sebastianbeyer/SO_hihat/kicad/hihat_BOM.md

# hihat.kicad_sch BOM

Tue 22 Nov 2022 12:08:40 CET

Generated from schematic by Eeschema 6.0.8-f2edbf62ab~116~ubuntu22.04.1

**Component Count:** 168

| Refs | Qty | Component | Description | Vendor | SKU |
| ----- | --- | ---- | --- | ---- | ---- |
| C1, C12 | 2 | 10n | Unpolarized capacitor | Tayda |  |
| C2, C3, C16 | 3 | 10u | Polarized capacitor | Tayda |  |
| C4 | 1 | 22n | Unpolarized capacitor | Tayda |  |
| C5, C8, C19 | 3 | 18n | Unpolarized capacitor | Tayda |  |
| C6, C7 | 2 | 3.3n | Unpolarized capacitor | Tayda |  |
| C9, C14, C15 | 3 | 10n | Unpolarized capacitor | Tayda |  |
| C10 | 1 | 47u | Polarized capacitor | Tayda |  |
| C11, C13 | 2 | .47u | Polarized capacitor | Tayda |  |
| C17, C18 | 2 | 1n | Unpolarized capacitor | Tayda |  |
| C20, C21, C27, C28, C29, C30, C31, C32 | 8 | 100n | Unpolarized capacitor |  |  |
| C22, C24 | 2 | 100n | Unpolarized capacitor | Tayda |  |
| C23 | 1 | 0.33u | Polarized capacitor | Tayda |  |
| C25 | 1 | 470n | Unpolarized capacitor | Tayda |  |
| C26 | 1 | 1u | Polarized capacitor | Tayda |  |
| D1, D2, D5, D6, D9 | 5 | 1N4148 | Standard switching diode, DO-35 | Tayda | A-157 |
| D3, D4 | 2 | 1N5817 | Schottky Barrier Rectifier Diode, DO-41 | Tayda | A-159 |
| D7 | 1 | LED_red_OH | Light emitting diode | Tayda | A-1554 |
| D8 | 1 | LED_red_CH | Light emitting diode | Tayda | A-1554 |
| H1, H2, H3, H4 | 4 | MountingHole | Mounting Hole with connection |  |  |
| J1 | 1 | Synth_power_2x5 | Pin header 2.54 mm 2x5 | Tayda | A-2939 |
| J2 | 1 | CH trig | Audio Jack, 2 Poles (Mono / TS), Switched T Pole (Normalling) | Tayda | A-1121 |
| J3 | 1 | accent | Audio Jack, 2 Poles (Mono / TS), Switched T Pole (Normalling) | Tayda | A-1121 |
| J4 | 1 | CH out | Audio Jack, 2 Poles (Mono / TS), Switched T Pole (Normalling) | Tayda | A-1121 |
| J5 | 1 | ctrl_north | Generic connector, single row, 01x12, script generated (kicad-library-utils/schlib/autogen/connector/) |  |  |
| J6 | 1 | brain_north | Generic connector, single row, 01x12, script generated (kicad-library-utils/schlib/autogen/connector/) |  |  |
| J7 | 1 | OH trig | Audio Jack, 2 Poles (Mono / TS), Switched T Pole (Normalling) | Tayda | A-1121 |
| J8 | 1 | OH out | Audio Jack, 2 Poles (Mono / TS), Switched T Pole (Normalling) | Tayda | A-1121 |
| J9 | 1 | ctrl_south | Generic connector, single row, 01x12, script generated (kicad-library-utils/schlib/autogen/connector/) |  |  |
| J10 | 1 | brain_south | Generic connector, single row, 01x12, script generated (kicad-library-utils/schlib/autogen/connector/) |  |  |
| J11 | 1 | CVin | Audio Jack, 2 Poles (Mono / TS), Switched T Pole (Normalling) | Tayda | A-1121 |
| Q1, Q4, Q5, Q6 | 4 | BC556 | 0.1A Ic, 65V Vce, PNP Small Signal Transistor, TO-92 |  |  |
| Q2, Q3, Q7, Q8, Q9, Q10, Q11, Q12, Q15, Q16 | 10 | BC546 | 0.1A Ic, 65V Vce, Small Signal NPN Transistor, TO-92 |  |  |
| Q13 | 1 | BC546 | 0.1A Ic, 65V Vce, Small Signal NPN Transistor, TO-92 |  |  |
| Q14 | 1 | 2N3904 | Small Signal NPN Transistor, TO-92 | Tayda | A-111 |
| R1, R35 | 2 | 47k | Resistor | Tayda |  |
| R2, R3, R4, R7, R9, R12, R16, R18, R36, R37, R56, R66, R68, R71, R78, R80, R81 | 17 | 100k | Resistor | Tayda |  |
| R5, R62 | 2 | 300k | Resistor | Tayda |  |
| R6, R74 | 2 | 82k | Resistor | Tayda |  |
| R8 | 1 | 270k | Resistor | Tayda |  |
| R10 | 1 | 220k | Resistor | Tayda |  |
| R11, R22, R24, R25, R40, R42, R43 | 7 | 22k | Resistor | Tayda |  |
| R13 | 1 | 680k | Resistor | Tayda |  |
| R14, R64, R77 | 3 | 20k | Resistor | Tayda |  |
| R15, R20, R27, R28, R39, R41, R46, R48, R59, R60, R61, R73 | 12 | 10k | Resistor | Tayda |  |
| R17, R30, R52, R79 | 4 | 100 | Resistor | Tayda |  |
| R19, R33, R34, R57, R58 | 5 | 470 | Resistor | Tayda |  |
| R21, R38, R67, R70 | 4 | 4.7k | Resistor | Tayda |  |
| R23, R44, R53 | 3 | 33k | Resistor | Tayda |  |
| R26, R31, R32, R50, R54, R55 | 6 | 1k | Resistor | Tayda |  |
| R29, R45, R49 | 3 | 15k | Resistor | Tayda |  |
| R47 | 1 | 1M | Resistor | Tayda |  |
| R63, R69 | 2 | 560k | Resistor | Tayda |  |
| R65 | 1 | 8.2k | Resistor | Tayda |  |
| R72 | 1 | 470k | Resistor | Tayda |  |
| R75, R76 | 2 | 2k | Resistor | Tayda |  |
| R82 | 1 | 75 | Resistor | Tayda |  |
| RV1 | 1 | 10k B OH drive | Potentiometer | Tayda |  |
| RV2 | 1 | 10k B CH drive | Potentiometer | Tayda |  |
| RV3 | 1 | 10k A tone | Potentiometer | Tayda |  |
| RV4 | 1 | 100k B CV att | Potentiometer | Tayda |  |
| RV5 | 1 | 100k B OH decay | Potentiometer | Tayda |  |
| RV6 | 1 | 100k B sizzle | Potentiometer | Tayda |  |
| RV7 | 1 | 50k | Trim-potentiometer | Tayda |  |
| SW1 | 1 | mute | Switch, single pole double throw, center OFF position |  |  |
| U1, U4, U8 | 3 | TL074 | Quad operational amplifier, DIP-14 | Tayda | A-1138 |
| U2 | 1 | LM7805_TO220 | Positive 1A 35V Linear Regulator, Fixed Output 5V, TO-220 |  |  |
| U5 | 1 | LM13700 | Dual OTA, DIP-16 | Tayda | A-900 |
| U6 | 1 | Vactrol | Vactrol |  |  |
| U7 | 1 | 40106 | Hex Schmitt trigger inverter |  |  |
