sebastianbeyer/SO_hihat/spice/808_filter_test_transistor_opamp.asc

C1: cap; 1n
C2: cap; 1n
C9: cap; 1n
C10: cap; 1.5n
C11: cap; 470p
C14: cap; 1n
C20: cap; 22n
C21: cap; 1.5n
C22: cap; 1.5n
C23: cap; 1.5n
D3: diode; 1N4148
Q6: npn; BC546B
Q13: npn; BC546B
Q17: npn; BC546B
R1: res; 18k
R2: res; 18k
R3: res; {Rf}
R4: res; 4.7k
R34: res; 2.7k
R35: res; 68k
R36: res; 22k
R55: res; 33k
R57: res; 2.7k
R58: res; 68k
R59: res; 22k
R65: res; 2Meg
R66: res; 100
U3: opamp2; TL074
V3: voltage; 12
V4: voltage; -12
V5: voltage; {V_acc}
V6: voltage; AC 1
Named nets: 0, VCC, VSS, V_accent, noise, transistor, sallen_key, 808_orig
.ac dec 100 1 20000
.inc TL074.mod
;.step param X list 100 25k 50k 250k 500k
;.step param V_acc list 1 2 5 7 10
.param V_acc=10
sallen key filter highpass
gain: 1+R3/R4
if C1=C2 and R1=R2, f_c = 1/(2pi RC)
;.step param Rf list 7k 8.2k 8.5k 9k 10k
.param Rf=8.2k
