sebastianbeyer/SO_hihat/spice/808_hihat_bandpass_checkfreqresponse.asc

C15: cap; 1n
C19: cap; 3.3n
C20: cap; 3.3n
R73: res; 22k
R75: res; 82k
U19: opamp2; TL074
V1: voltage; AC 1
V3: voltage; 12
V4: voltage; -12
X4: pot_log; R=10k Rot={Rot_filter}
Named nets: 0, VCC, VSS, noise
.inc TL074.mod
.lib lm13700.sub
;.step param Rot_filter list 1 10 20 30 40 50 60 70 80 90 99
.param Rot_filter=20
.ac dec 100 1 20000
;.step param Rot_filter list 99 1
