sebastianbeyer/SO_hihat/spice/808_hihat_check_overdrivewithsinewave.asc

C1: cap; 0.01µ
C2: cap; 0.01µ
C5: cap; 10µ
C7: cap; 0.47µ
C10: cap; 10µ
C11: cap; 10µ
C16: cap; 0.47µ
C17: cap; 47µ
C18: cap; 0.01µ
D1: diode; 1N4148
D2: diode; 1N4148
D4: diode; 1N4148
Q1: npn; BC546B
Q2: pnp; BC556B
Q3: pnp; BC556B
Q5: npn; BC546B
Q13: npn; BC546B
Q14: pnp; BC556B
Q15: npn; BC546B
Q16: npn; BC546B
Q17: npn; BC546B
Q18: npn; BC546B
Q19: npn; BC546B
Q20: pnp; BC556B
R1: res; 47k
R2: res; 22k
R3: res; 10k
R4: res; 1k
R5: res; 10k
R6: res; 100k; tol=1
R11: res; 1k
R12: res; 470
R13: res; 470
R14: res; 100
R15: res; 10k
R16: res; 15k
R17: res; 100k
R18: res; 8k
R19: res; 100k
R20: res; 22k
R22: res; 1k
R24: res; 4.7k
R25: res; 22k
R26: res; 100k; tol=1
R27: res; 100k
R30: res; 10k
R31: res; 100k
R33: res; 1k
R34: res; 10k
R35: res; 10k
R36: res; 1Meg
R37: res; 470
R38: res; 470
R39: res; 33k
R41: res; 33k
R42: res; 100k
R43: res; 100
R44: res; 10k
R45: res; 10k
R46: res; {R_choke}
R47: res; 14k
R48: res; 1k
R49: res; 15k
R50: res; 100k
R51: res; 8k
R52: res; 22k
R53: res; 10k
R54: res; 22k
R56: res; 100
R57: res; 100k
R60: res; 4.7k
R61: res; 470
R62: res; 22k
R63: res; 33k
R64: res; 100k; tol=1
R67: res; 1k
R68: res; 10k
U1: opamp2; TL074
U2: LM13700
U3: opamp2; TL074
U4: opamp2; TL074
U5: opamp2; TL074
U7: LM13700
U8: opamp2; TL074
U9: opamp2; TL074
U10: opamp2; TL074
U13: opamp2; TL074
U16: opamp2; TL074
V1: voltage; PULSE(0 5 0.3 0.0001 0.0001 0.1)
V2: voltage; PULSE(0 5 0.1 0.0001 0.0001 0.1)
V3: voltage; 12
V4: voltage; -12
V5: voltage; {V_acc}
V6: voltage; SINE(0 3 10000)
V7: voltage; PULSE(0 5 0.02 0.0001 0.0001 0.1)
X1: pot_lin; R=100k Rot={Rot_decay}
X2: pot_lin; R=10k Rot={Rot_drive}
X3: pot_lin; R=10k Rot={Rot_drive}
Named nets: 0, VCC, VSS, V_accent, accent, CH_trig, CH_env, 12V_isolation, OH_trig, OH_env, filtered_noise, wavout_ota_ch, ch_ota_out, noise, wavout_ota_oh, oh_ota_out
.tran 1 uic
.inc TL074.mod
;.step param X list 100 25k 50k 250k 500k
.lib lm13700.sub
Envelope generator
;.step param V_acc list 1 2 5 7 10
.param V_acc=10
;.step param R_choke list 10k 300k 100000meg
.param R_choke=10000000meg
;.step param Rot_decay list 0.1 10 20 30 40 50 60 70 80 90 99
.lib lm13700.sub
.wave {Rot_sizzle} 16 44.1K V(wavout_ota_ch) V(wavout_ota_oh)
.param Rot_decay 50
;.param Rot_drive=60
.step param Rot_drive list 0.1 10 20 30 40 50 60 70 80 90 99
;.wave hihat_ota_open.wav 16 44.1K V(wavout_ota_oh)
;.wave hihat_ota_combined.wav 16 44.1K V(wavout_ota_ch)
