sebastianbeyer/SO_hihat/spice/808_hihat_completo.asc

B1: bi; V=WHITE(2e6*time)*5
C1: cap; 0.01µ
C2: cap; 0.01µ
C3: cap; 1n
C4: cap; 1n
C5: cap; 10µ
C6: cap; 10n
C7: cap; 0.47µ
C8: cap; 22.44n
C9: cap; 18n
C10: cap; 10µ
C11: cap; 10µ
C12: cap; 18n
C13: cap; 10n
C14: cap; 9.256n
C15: cap; 1n
C16: cap; 0.47µ
C17: cap; 47µ
C18: cap; 0.01µ
C19: cap; 3.3n
C20: cap; 3.3n
D1: diode; 1N4148
D2: diode; 1N4148
D4: diode; 1N4148
Q1: npn; BC546B
Q2: pnp; BC556B
Q3: pnp; BC556B
Q5: npn; BC546B
Q13: npn; BC546B
Q14: pnp; BC556B
Q15: npn; BC546B
Q16: npn; BC546B
Q17: npn; BC546B
Q18: npn; BC546B
Q19: npn; BC546B
Q20: pnp; BC556B
R1: res; 47k
R2: res; 22k
R3: res; 10k
R4: res; 1k
R5: res; 10k
R6: res; 100k; tol=1
R7: res; 18k
R8: res; 18k
R9: res; 8.2k
R10: res; 4.7k
R11: res; 1k
R12: res; 470
R13: res; 470
R14: res; 100
R15: res; 10k
R16: res; 15k
R17: res; 100k
R18: res; 8k
R19: res; 100k
R20: res; 22k
R21: res; 100k
R22: res; 1k
R23: res; 560k
R24: res; 4.7k
R25: res; 22k
R26: res; 100k; tol=1
R27: res; 100k
R28: res; 100k
R29: res; 299k
R30: res; 10k
R31: res; 100k
R32: res; 100k
R33: res; 1k
R34: res; 10k
R35: res; 10k
R36: res; 1Meg
R37: res; 470
R38: res; 470
R39: res; 33k
R41: res; 33k
R42: res; 100k
R43: res; 100
R44: res; 10k
R45: res; 10k
R46: res; {R_choke}
R47: res; 14k
R48: res; 1k
R49: res; 15k
R50: res; 100k
R51: res; 8k
R52: res; 22k
R53: res; 10k
R54: res; 22k
R55: res; 270k
R56: res; 100
R57: res; 100k
R58: res; 100k
R59: res; 220k
R60: res; 4.7k
R61: res; 470
R62: res; 22k
R63: res; 33k
R64: res; 100k; tol=1
R65: res; 100k
R66: res; 680k
R67: res; 1k
R68: res; 10k
R69: res; 100k
R70: res; 556.6k
R71: res; 100k
R72: res; 100k
R73: res; 22k
R74: res; 10k
R75: res; 82k
R76: res; 50k
U1: opamp2; TL074
U2: LM13700
U3: opamp2; TL074
U4: opamp2; TL074
U5: opamp2; TL074
U6: opamp2; TL074
U7: LM13700
U8: opamp2; TL074
U9: opamp2; TL074
U10: opamp2; TL074
U11: CD40106B
U12: CD40106B
U13: opamp2; TL074
U14: CD40106B
U15: CD40106B
U16: opamp2; TL074
U17: CD40106B
U18: CD40106B
U19: opamp2; TL074
U20: opamp2; TL074
V1: voltage; PULSE(0 5 0.3 0.0001 0.0001 0.1)
V2: voltage; PULSE(0 5 0.1 0.0001 0.0001 0.1)
V3: voltage; 12
V4: voltage; -12
V5: voltage; {V_acc}
V6: voltage; SINE(0 0.2 10000)
V7: voltage; PULSE(0 5 0.02 0.0001 0.0001 0.1)
X1: pot_lin; R=100k Rot={Rot_decay}
X2: pot_lin; R=10k Rot={Rot_drive}
X3: pot_lin; R=10k Rot={Rot_drive}
X4: pot_log; R=10k Rot={Rot_filter}
X5: pot_lin; R=10k Rot={Rot_drive}
Named nets: 0, VCC, VSS, V_accent, accent, CH_trig, CH_env, 12V_isolation, OH_trig, OH_env, filtered_noise, wavout_ota_ch, ch_ota_out, noise, wavout_ota_oh, oh_ota_out
.tran .05 uic
.inc TL074.mod
;.step param X list 100 25k 50k 250k 500k
.lib lm13700.sub
Envelope generator
.inc CD4000.lib
;.step param V_acc list 1 2 5 7 10
.param V_acc=10
;.step param R_choke list 10k 300k 100000meg
.param R_choke=10000000meg
;.step param Rot_decay list 0.1 10 20 30 40 50 60 70 80 90 99
.lib lm13700.sub
.wave {Rot_drive} 16 44.1K V(wavout_ota_ch) V(wavout_ota_oh)
.param Rot_decay 50
sallen key filter highpass
gain: 1+R3/R4
if C1=C2 and R1=R2, f_c = 1/(2pi RC)
;.param Rot_drive=60
.step param Rot_drive list 0.1 10 20 30 40 50 60 70 80 90 99
;.wave hihat_ota_open.wav 16 44.1K V(wavout_ota_oh)
;.step param Rot_filter list 1 10 20 30 40 50 60 70 80 90 99
.param Rot_filter=25
;.wave hihat_ota_combined.wav 16 44.1K V(wavout_ota_ch)
V=WHITE(2e6*time)*10
.param Rot_sizzle=10
;.step param Rot_sizzle list 1 5 10 20 30 40 50 60 70 90 99
