sebastianbeyer/SO_hihat/spice/pot_lin.asc

R1: res; {Ra}
R2: res; {Rb}
Named nets: 1, 2, 3
.param Ra=R*(Rot/100)
.param Rb=R*(1-(Rot/100))
