sebastianbeyer/SO_hihat/spice/pot_log.asc

R1: res; {Ra}
R2: res; {Rb}
Named nets: 1, 2, 3
.param Ra={if(Rot<=50,R*(Rot/100/5),R*(Rot/100*2.2-1.2))}
.param Rb={R-Ra}
