sebastianbeyer/SO_hihat/kicad/hihat.kicad_pcb

## KiCad design kicad/hihat.kicad_pcb (2022-02-02)

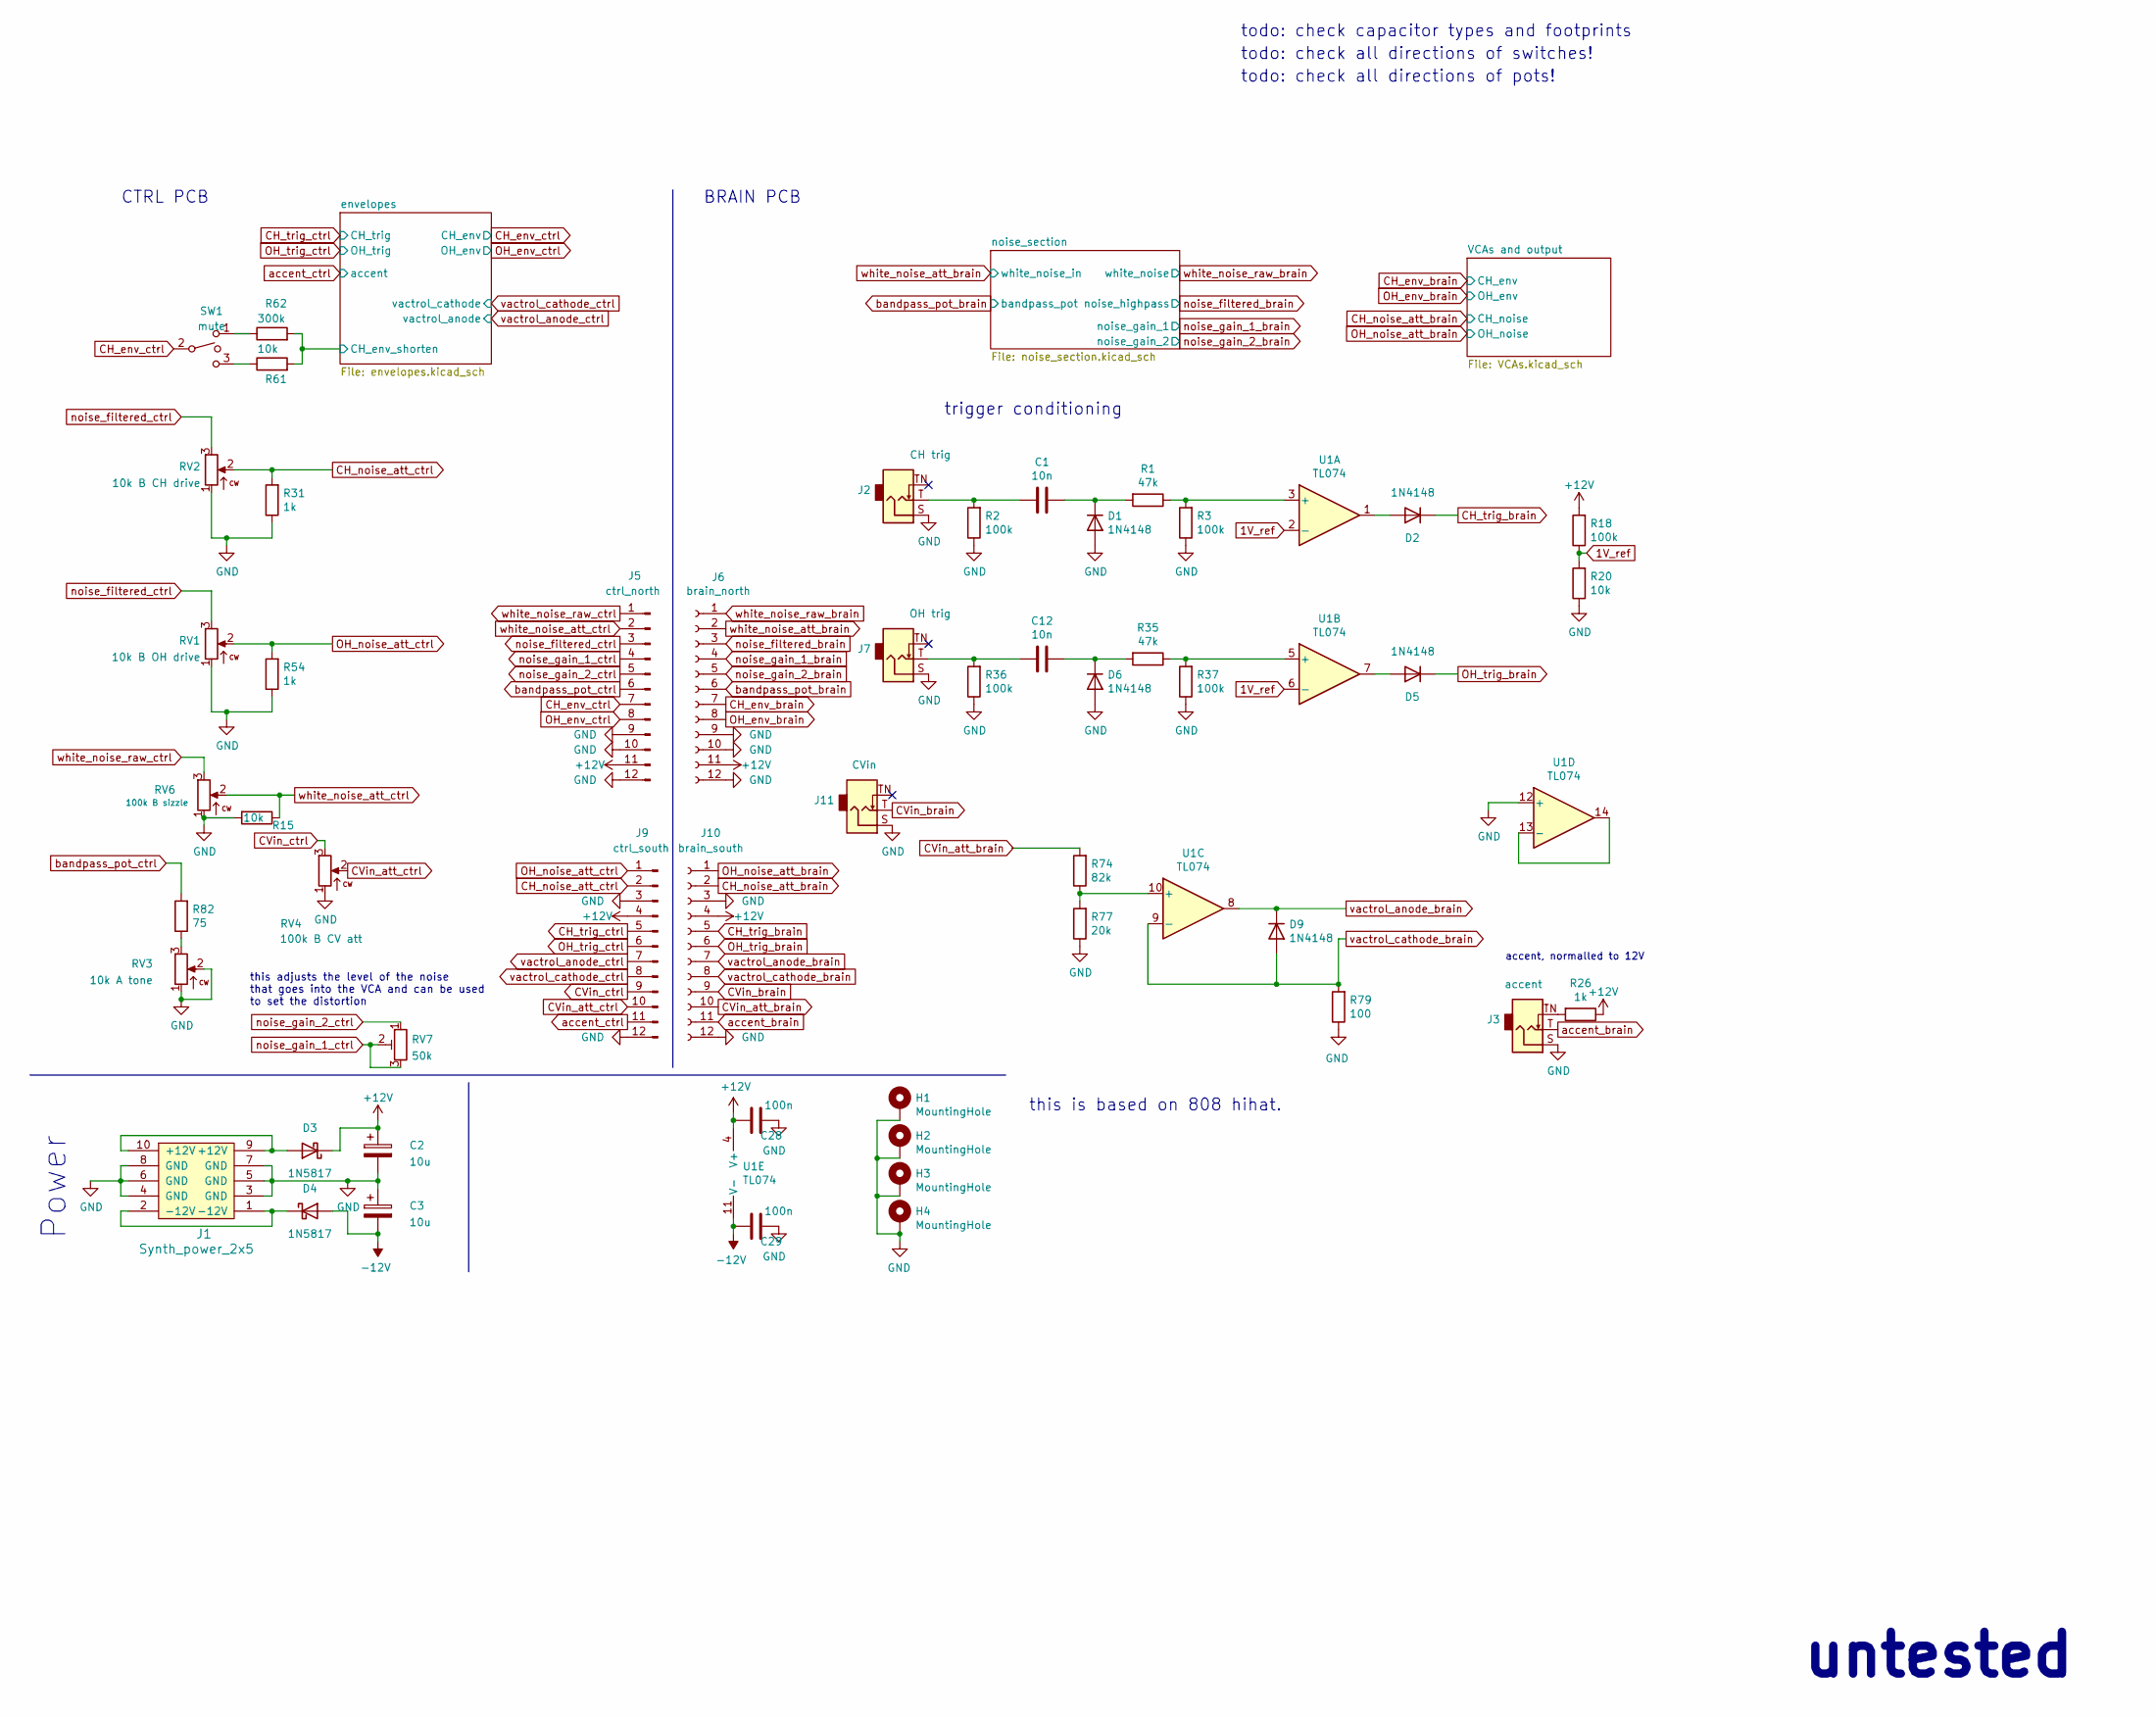
[picture p1: schematic hihat.kicad_sch]

Parts:
C1, C12: 10n; C_Disc_D3.0mm_W1.6mm_P2.50mm
C2, C3: 10u; CP_Radial_horizontalflat_D5mm_P2.50mm_H10mm
C28, C29: 100n; C_Disc_D3.0mm_W1.6mm_P2.50mm
D1, D2, D5, D6, D9: 1N4148; D_DO-35_SOD27_P7.62mm_Horizontal
D3, D4: 1N5817; D_DO-41_SOD81_P10.16mm_Horizontal
H1, H2, H3, H4: MountingHole; MountingHole_3.2mm_M3_Pad
J1: Synth_power_2x5; Power_Header
J2: CH trig; Jack_6.35mm_PJ_629HAN
J3: accent; Jack_6.35mm_PJ_629HAN
J5: ctrl_north; PinHeader_1x12_P2.54mm_Vertical
J6: brain_north; PinSocket_1x12_P2.54mm_Vertical
J7: OH trig; Jack_6.35mm_PJ_629HAN
J9: ctrl_south; PinHeader_1x12_P2.54mm_Vertical
J10: brain_south; PinSocket_1x12_P2.54mm_Vertical
J11: CVin; Jack_6.35mm_PJ_629HAN
R1, R35: 47k; R_Axial_DIN0207_L6.3mm_D2.5mm_P10.16mm_Horizontal
R2, R3, R18, R36, R37: 100k; R_Axial_DIN0207_L6.3mm_D2.5mm_P10.16mm_Horizontal
R15, R20, R61: 10k; R_Axial_DIN0207_L6.3mm_D2.5mm_P10.16mm_Horizontal
R26, R31, R54: 1k; R_Axial_DIN0207_L6.3mm_D2.5mm_P10.16mm_Horizontal
R62: 300k; R_Axial_DIN0207_L6.3mm_D2.5mm_P10.16mm_Horizontal
R74: 82k; R_Axial_DIN0207_L6.3mm_D2.5mm_P10.16mm_Horizontal
R77: 20k; R_Axial_DIN0207_L6.3mm_D2.5mm_P10.16mm_Horizontal
R79: 100; R_Axial_DIN0207_L6.3mm_D2.5mm_P10.16mm_Horizontal
R82: 75; R_Axial_DIN0207_L6.3mm_D2.5mm_P10.16mm_Horizontal
RV1: 10k B OH drive; Potentiometer_Alpha_RD901F-40-00D_Single_Vertical_centered
RV2: 10k B CH drive; Potentiometer_Alpha_RD901F-40-00D_Single_Vertical_centered
RV3: 10k A tone; Potentiometer_Alpha_RD901F-40-00D_Single_Vertical_centered
RV4: 100k B CV att; Potentiometer_Alpha_RD901F-40-00D_Single_Vertical_centered
RV6: 100k B sizzle; Potentiometer_Alpha_RD901F-40-00D_Single_Vertical_centered
RV7: 50k; Potentiometer_Bourns_3296W_Vertical_standard
SW1: mute; SPDT-toggle-switch-1M-series
U1: TL074; DIP-14_W7.62mm_Socket_LongPads

Connections:
1V_ref: R18.1, R20.2, U1.2 (-), U1.6 (-)
+12V: C2.1, C28.2, D3.1 (K), J5.11, J6.11, J9.4, J10.4, R18.2, R26.1, U1.4 (V+); also elsewhere on the board
-12V: C3.2, C29.2, D4.2 (A), U1.11 (V-); also elsewhere on the board
/envelopes/CH_env_shorten: R61.2, R62.2; also elsewhere on the board
CH_env_brain: J6.7; also elsewhere on the board
CH_env_ctrl: J5.7, SW1.2; also elsewhere on the board
CH_noise_att_brain: J10.2; also elsewhere on the board
CH_noise_att_ctrl: J9.2, R31.2, RV2.2
CH_trig_brain: D2.1 (K), J10.5
CH_trig_ctrl: J9.5; also elsewhere on the board
CVin_att_brain: J10.10, R74.2
CVin_att_ctrl: J9.10, RV4.2
CVin_brain: J10.9, J11.T
CVin_ctrl: J9.9, RV4.3
GND: C2.2, C3.1, C28.1, C29.1, D1.2 (A), D6.2 (A), H1.1, H2.1, H3.1, H4.1, J1.3 (GND), J1.4 (GND), J1.5 (GND), J1.6 (GND), J1.7 (GND), J1.8 (GND), J2.S, J3.S, J5.9, J5.10, J5.12, J6.9, J6.10, J6.12, J7.S, J9.3, J9.12, J10.3, J10.12, J11.S, R2.1, R3.1, R15.2, R20.1, R31.1, R36.1, R37.1, R54.1, R77.1, R79.1, RV1.1, RV2.1, RV3.1, RV3.2, RV4.1, RV6.1, U1.12 (+); also elsewhere on the board
unnamed: C1.1, D1.1 (K), R1.2
unnamed: C1.2, J2.T, R2.2
unnamed: C12.1, D6.1 (K), R35.2
unnamed: C12.2, J7.T, R36.2
unnamed: D2.2 (A), U1.1
unnamed: D3.2 (A), J1.9 (+12V), J1.10 (+12V)
unnamed: D4.1 (K), J1.1 (-12V), J1.2 (-12V)
unnamed: D5.2 (A), U1.7
unnamed: J3.TN, R26.2
unnamed: R1.1, R3.2, U1.3 (+)
unnamed: R35.1, R37.2, U1.5 (+)
unnamed: R61.1, SW1.3
unnamed: R62.1, SW1.1
unnamed: R74.1, R77.2, U1.10 (+)
unnamed: R82.1, RV3.3
unnamed: U1.13 (-), U1.14
OH_env_brain: J6.8; also elsewhere on the board
OH_env_ctrl: J5.8; also elsewhere on the board
OH_noise_att_brain: J10.1; also elsewhere on the board
OH_noise_att_ctrl: J9.1, R54.2, RV1.2
OH_trig_brain: D5.1 (K), J10.6
OH_trig_ctrl: J9.6; also elsewhere on the board
accent_brain: J3.T, J10.11
accent_ctrl: J9.11; also elsewhere on the board
bandpass_pot_brain: J6.6; also elsewhere on the board
bandpass_pot_ctrl: J5.6, R82.2
noise_filtered_brain: J6.3, J6.5; also elsewhere on the board
noise_filtered_ctrl: J5.3, RV1.3, RV2.3
noise_gain_1_brain: J6.4; also elsewhere on the board
noise_gain_1_ctrl: J5.4, RV7.2, RV7.3
noise_gain_2_ctrl: J5.5, RV7.1
vactrol_anode_brain: D9.1 (K), J10.7, U1.8
vactrol_anode_ctrl: J9.7; also elsewhere on the board
vactrol_cathode_brain: D9.2 (A), J10.8, R79.2, U1.9 (-)
vactrol_cathode_ctrl: J9.8; also elsewhere on the board
white_noise_att_brain: J6.2; also elsewhere on the board
white_noise_att_ctrl: J5.2, R15.1, RV6.2
white_noise_raw_brain: J6.1; also elsewhere on the board
white_noise_raw_ctrl: J5.1, RV6.3

Notes on the sheet:
untested
trigger conditioning
CTRL PCB
accent, normalled to 12V
todo: check all directions of switches!
this is based on 808 hihat.
Power
todo: check capacitor types and footprints
todo: check all directions of pots!
this adjusts the level of the noise that goes into the VCA and can be used to set the distortion
BRAIN PCB

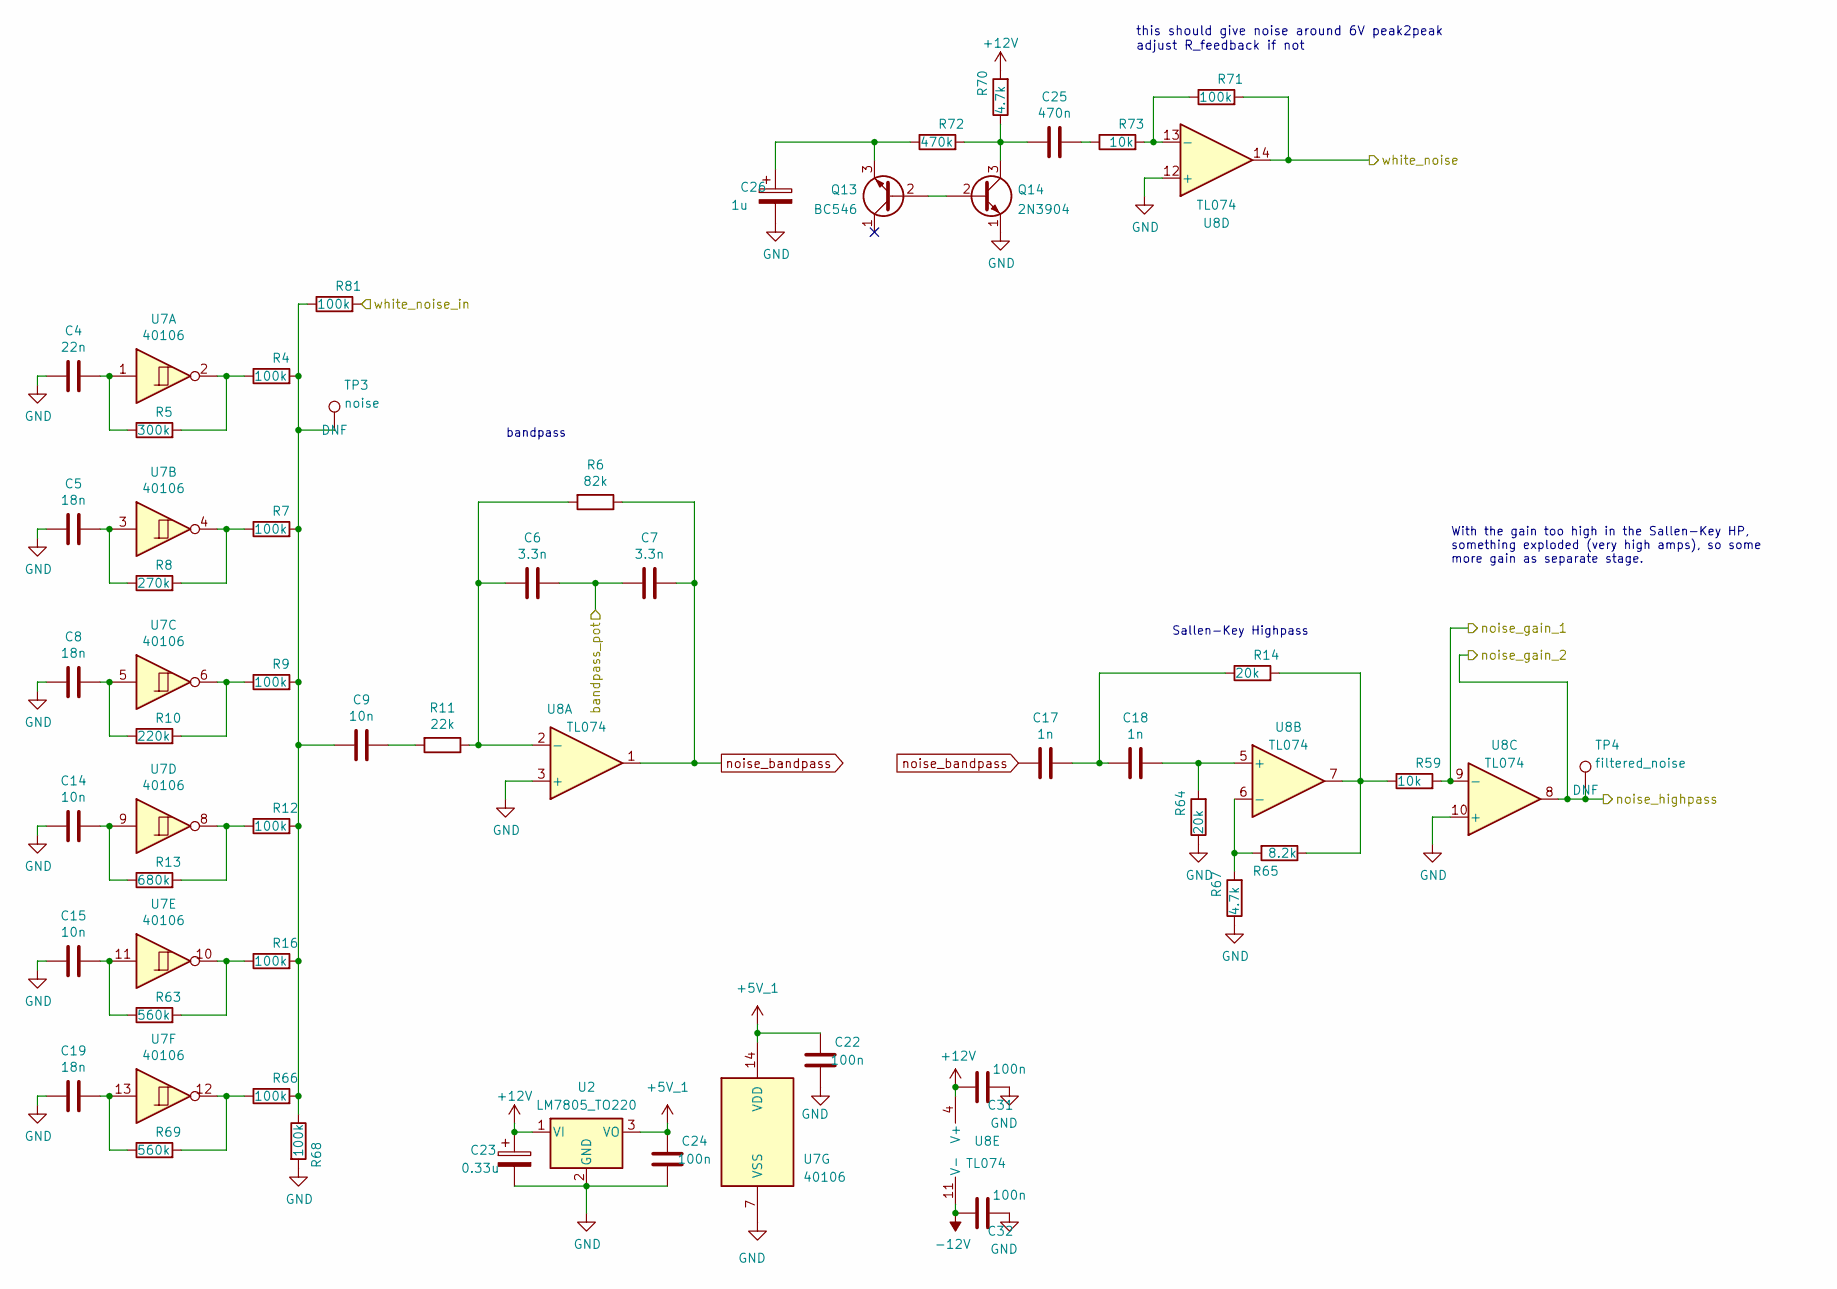
[picture p2: schematic noise_section.kicad_sch, hihat]

Parts:
C4: 22n; C_Rect_L7.2mm_W2.5mm_P5.00mm_FKS2_FKP2_MKS2_MKP2
C5, C8, C19: 18n; C_Rect_L7.2mm_W2.5mm_P5.00mm_FKS2_FKP2_MKS2_MKP2
C6, C7: 3.3n; C_Rect_L7.2mm_W2.5mm_P5.00mm_FKS2_FKP2_MKS2_MKP2
C9, C14, C15: 10n; C_Rect_L7.2mm_W2.5mm_P5.00mm_FKS2_FKP2_MKS2_MKP2
C17, C18: 1n; C_Rect_L7.2mm_W2.5mm_P5.00mm_FKS2_FKP2_MKS2_MKP2
C22, C24, C31, C32: 100n; C_Disc_D3.0mm_W1.6mm_P2.50mm
C23: 0.33u; CP_Radial_horizontalflat_D5mm_P2.50mm_H10mm
C25: 470n; C_Rect_L7.2mm_W2.5mm_P5.00mm_FKS2_FKP2_MKS2_MKP2
C26: 1u; CP_Radial_horizontalflat_D5mm_P2.50mm_H10mm
Q13: BC546; TO-92_Inline_Wide
Q14: 2N3904; TO-92_Inline_Wide
R4, R7, R9, R12, R16, R66, R68, R71, R81: 100k; R_Axial_DIN0207_L6.3mm_D2.5mm_P10.16mm_Horizontal
R5: 300k; R_Axial_DIN0207_L6.3mm_D2.5mm_P10.16mm_Horizontal
R6: 82k; R_Axial_DIN0207_L6.3mm_D2.5mm_P10.16mm_Horizontal
R8: 270k; R_Axial_DIN0207_L6.3mm_D2.5mm_P10.16mm_Horizontal
R10: 220k; R_Axial_DIN0207_L6.3mm_D2.5mm_P10.16mm_Horizontal
R11: 22k; R_Axial_DIN0207_L6.3mm_D2.5mm_P10.16mm_Horizontal
R13: 680k; R_Axial_DIN0207_L6.3mm_D2.5mm_P10.16mm_Horizontal
R14, R64: 20k; R_Axial_DIN0207_L6.3mm_D2.5mm_P10.16mm_Horizontal
R59, R73: 10k; R_Axial_DIN0207_L6.3mm_D2.5mm_P10.16mm_Horizontal
R63, R69: 560k; R_Axial_DIN0207_L6.3mm_D2.5mm_P10.16mm_Horizontal
R65: 8.2k; R_Axial_DIN0207_L6.3mm_D2.5mm_P10.16mm_Horizontal
R67, R70: 4.7k; R_Axial_DIN0207_L6.3mm_D2.5mm_P10.16mm_Horizontal
R72: 470k; R_Axial_DIN0207_L6.3mm_D2.5mm_P10.16mm_Horizontal
TP3: noise; TestPoint_THTPad_D1.5mm_Drill0.7mm
TP4: filtered_noise; TestPoint_THTPad_D1.5mm_Drill0.7mm
U2: LM7805_TO220; TO-220-3_Horizontal_TabDown
U7: 40106; DIP-14_W7.62mm_Socket_LongPads
U8: TL074; DIP-14_W7.62mm_Socket_LongPads

Connections:
+5V_1: C22.1, C24.1, U2.3 (VO), U7.14 (VDD)
+12V: C23.1, C31.2, R70.2, U2.1 (VI), U8.4 (V+); also elsewhere on the board
-12V: C32.2, U8.11 (V-); also elsewhere on the board
GND: C4.2, C5.2, C8.2, C14.2, C15.2, C19.2, C22.2, C23.2, C24.2, C26.2, C31.1, C32.1, Q14.1 (E), R64.1, R67.1, R68.2, U2.2 (GND), U7.7 (VSS), U8.3 (+), U8.10 (+), U8.12 (+); also elsewhere on the board
unnamed: C4.1, R5.1, U7.1
unnamed: C5.1, R8.1, U7.3
unnamed: C6.2, R6.2, R11.1, U8.2 (-)
unnamed: C8.1, R10.1, U7.5
unnamed: C9.1, R11.2
unnamed: C9.2, R4.2, R7.2, R9.2, R12.2, R16.2, R66.2, R68.1, R81.1, TP3.1
unnamed: C14.1, R13.1, U7.9
unnamed: C15.1, R63.1, U7.11
unnamed: C17.1, C18.2, R14.1
unnamed: C18.1, R64.2, U8.5 (+)
unnamed: C19.1, R69.1, U7.13
unnamed: C25.1, R73.1
unnamed: C25.2, Q14.3 (C), R70.1, R72.2
unnamed: C26.1, Q13.3 (E), R72.1
unnamed: Q13.2 (B), Q14.2 (B)
unnamed: R4.1, R5.2, U7.2
unnamed: R7.1, R8.2, U7.4
unnamed: R9.1, R10.2, U7.6
unnamed: R12.1, R13.2, U7.8
unnamed: R14.2, R59.1, R65.1, U8.7
unnamed: R16.1, R63.2, U7.10
unnamed: R65.2, R67.2, U8.6 (-)
unnamed: R66.1, R69.2, U7.12
unnamed: R71.1, R73.2, U8.13 (-)
bandpass_pot_brain: C6.1, C7.2; also elsewhere on the board
noise_bandpass: C7.1, C17.2, R6.1, U8.1
noise_filtered_brain: TP4.1, U8.8; also elsewhere on the board
noise_gain_1_brain: R59.2, U8.9 (-); also elsewhere on the board
white_noise_att_brain: R81.2; also elsewhere on the board
white_noise_raw_brain: R71.2, U8.14; also elsewhere on the board

Notes on the sheet:
With the gain too high in the Sallen-Key HP, something exploded (very high amps), so some more gain as separate stage.
bandpass
this should give noise around 6V peak2peak adjust R_feedback if not
Sallen-Key Highpass

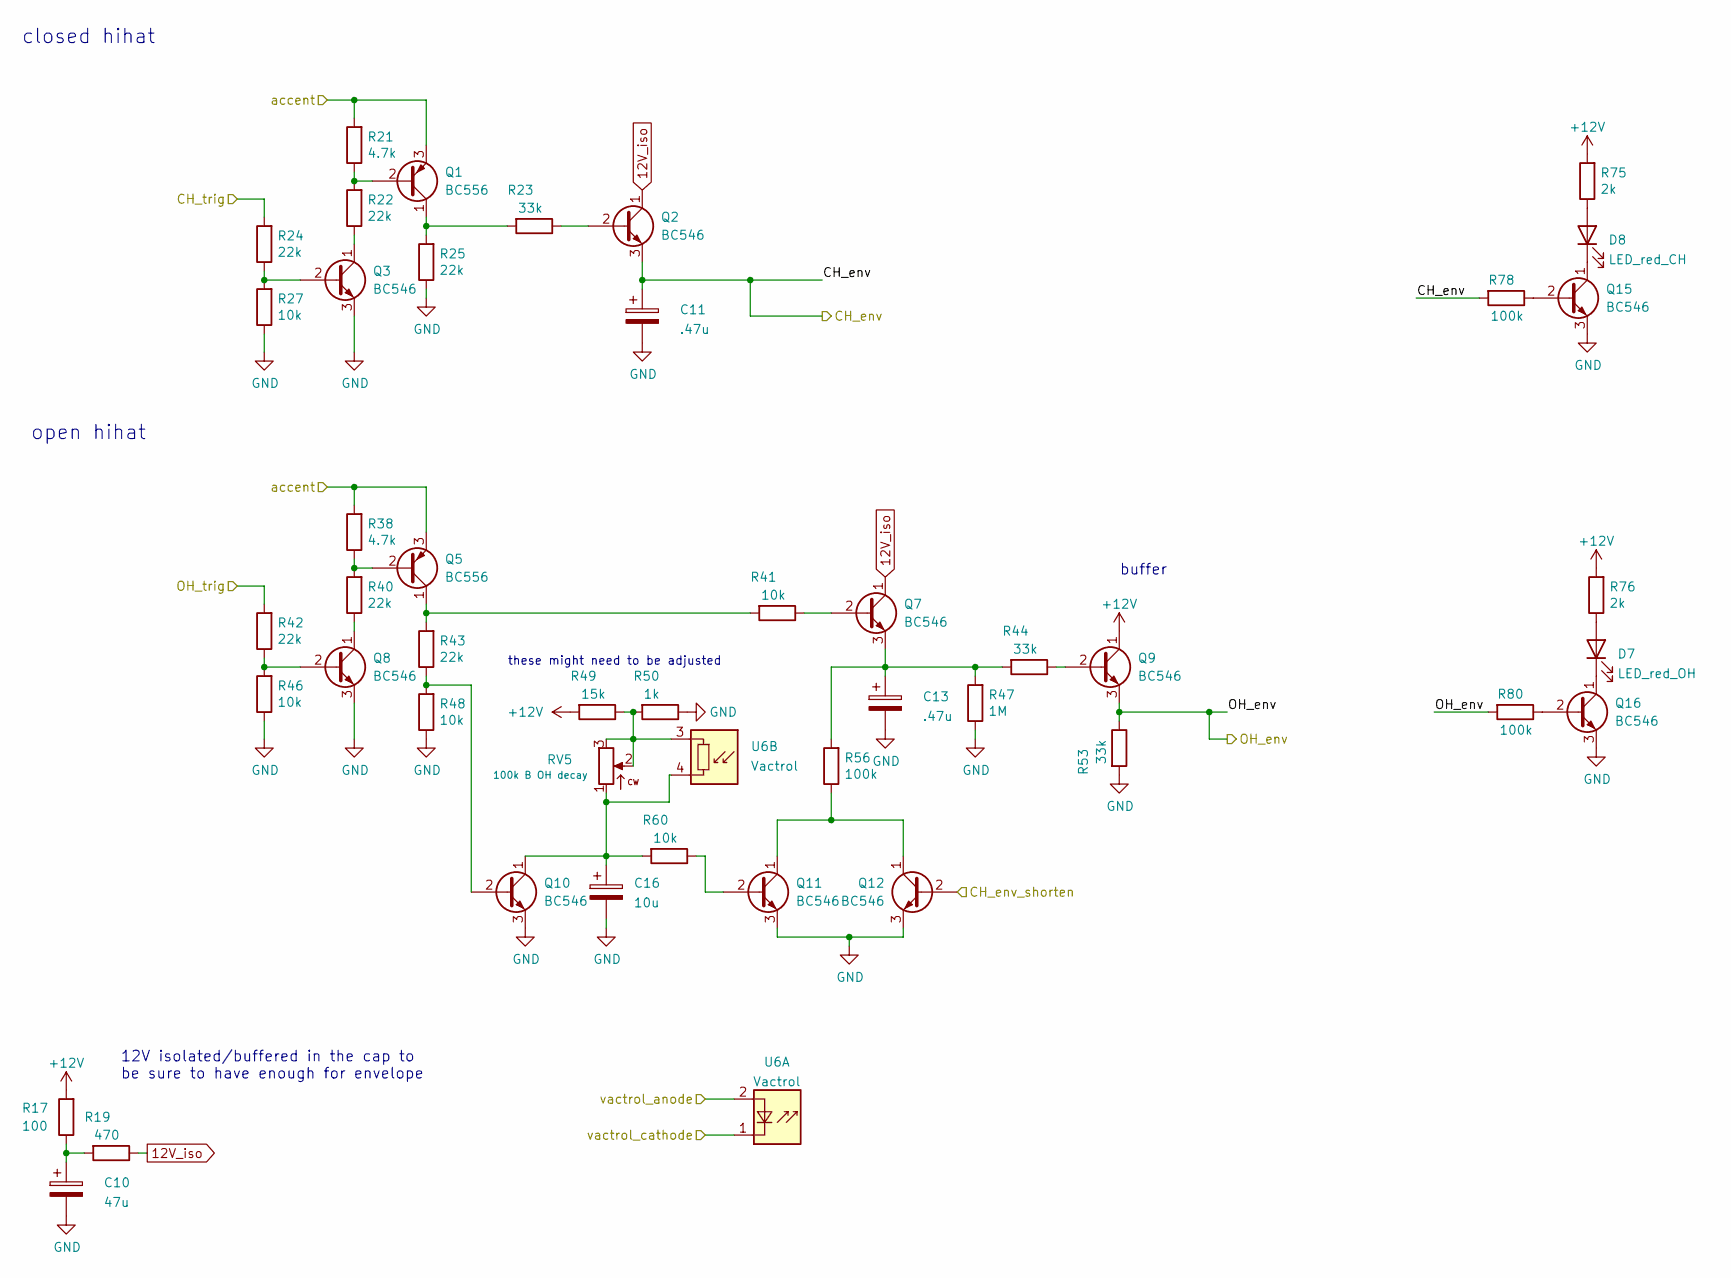
[picture p3: schematic envelopes.kicad_sch, hihat]

Parts:
C10: 47u; CP_Radial_horizontalflat_D5mm_P2.50mm_H10mm_south
C11, C13: .47u; CP_Radial_horizontalflat_D5mm_P2.50mm_H10mm
C16: 10u; CP_Radial_horizontalflat_D5mm_P2.50mm_H10mm
D7: LED_red_OH; LED_D5.0mm
D8: LED_red_CH; LED_D5.0mm
Q1, Q5: BC556; TO-92_Inline_Wide
Q2, Q3, Q7, Q8, Q9, Q10, Q11, Q12, Q15, Q16: BC546; TO-92_Inline_Wide
R17: 100; R_Axial_DIN0207_L6.3mm_D2.5mm_P10.16mm_Horizontal
R19: 470; R_Axial_DIN0207_L6.3mm_D2.5mm_P10.16mm_Horizontal
R21, R38: 4.7k; R_Axial_DIN0207_L6.3mm_D2.5mm_P10.16mm_Horizontal
R22, R24, R25, R40, R42, R43: 22k; R_Axial_DIN0207_L6.3mm_D2.5mm_P10.16mm_Horizontal
R23, R44, R53: 33k; R_Axial_DIN0207_L6.3mm_D2.5mm_P10.16mm_Horizontal
R27, R41, R46, R48, R60: 10k; R_Axial_DIN0207_L6.3mm_D2.5mm_P10.16mm_Horizontal
R47: 1M; R_Axial_DIN0207_L6.3mm_D2.5mm_P10.16mm_Horizontal
R49: 15k; R_Axial_DIN0207_L6.3mm_D2.5mm_P10.16mm_Horizontal
R50: 1k; R_Axial_DIN0207_L6.3mm_D2.5mm_P10.16mm_Horizontal
R56, R78, R80: 100k; R_Axial_DIN0207_L6.3mm_D2.5mm_P10.16mm_Horizontal
R75, R76: 2k; R_Axial_DIN0207_L6.3mm_D2.5mm_P10.16mm_Horizontal
RV5: 100k B OH decay; Potentiometer_Alpha_RD901F-40-00D_Single_Vertical_centered
U6: Vactrol; vactrol_Luna_NSL-32_with_diagram

Connections:
12V_iso: Q2.1 (C), Q7.1 (C), R19.1
+12V: Q9.1 (C), R17.2, R49.2, R75.2, R76.2; also elsewhere on the board
/envelopes/CH_env_shorten: Q12.2 (B); also elsewhere on the board
CH_env_ctrl: C11.1, Q2.3 (E), R78.2; also elsewhere on the board
CH_trig_ctrl: R24.2; also elsewhere on the board
GND: C10.2, C11.2, C13.2, C16.2, Q3.3 (E), Q8.3 (E), Q10.3 (E), Q11.3 (E), Q12.3 (E), Q15.3 (E), Q16.3 (E), R25.1, R27.1, R46.1, R47.1, R48.1, R50.1, R53.2; also elsewhere on the board
unnamed: C10.1, R17.1, R19.2
unnamed: C13.1, Q7.3 (E), R44.2, R47.2, R56.2
unnamed: C16.1, Q10.1 (C), R60.2, RV5.1, U6.4
unnamed: D7.1 (K), Q16.1 (C)
unnamed: D7.2 (A), R76.1
unnamed: D8.1 (K), Q15.1 (C)
unnamed: D8.2 (A), R75.1
unnamed: Q1.1 (C), R23.2, R25.2
unnamed: Q1.2 (B), R21.1, R22.2
unnamed: Q2.2 (B), R23.1
unnamed: Q3.1 (C), R22.1
unnamed: Q3.2 (B), R24.1, R27.2
unnamed: Q5.1 (C), R41.2, R43.2
unnamed: Q5.2 (B), R38.1, R40.2
unnamed: Q7.2 (B), R41.1
unnamed: Q8.1 (C), R40.1
unnamed: Q8.2 (B), R42.1, R46.2
unnamed: Q9.2 (B), R44.1
unnamed: Q10.2 (B), R43.1, R48.2
unnamed: Q11.1 (C), Q12.1 (C), R56.1
unnamed: Q11.2 (B), R60.1
unnamed: Q15.2 (B), R78.1
unnamed: Q16.2 (B), R80.1
unnamed: R49.1, R50.2, RV5.2, RV5.3, U6.3
OH_env_ctrl: Q9.3 (E), R53.1, R80.2; also elsewhere on the board
OH_trig_ctrl: R42.2; also elsewhere on the board
accent_ctrl: Q1.3 (E), Q5.3 (E), R21.2, R38.2; also elsewhere on the board
vactrol_anode_ctrl: U6.2 (+); also elsewhere on the board
vactrol_cathode_ctrl: U6.1 (-); also elsewhere on the board

Notes on the sheet:
these might need to be adjusted
open hihat
closed hihat
12V isolated/buffered in the cap to be sure to have enough for envelope
buffer

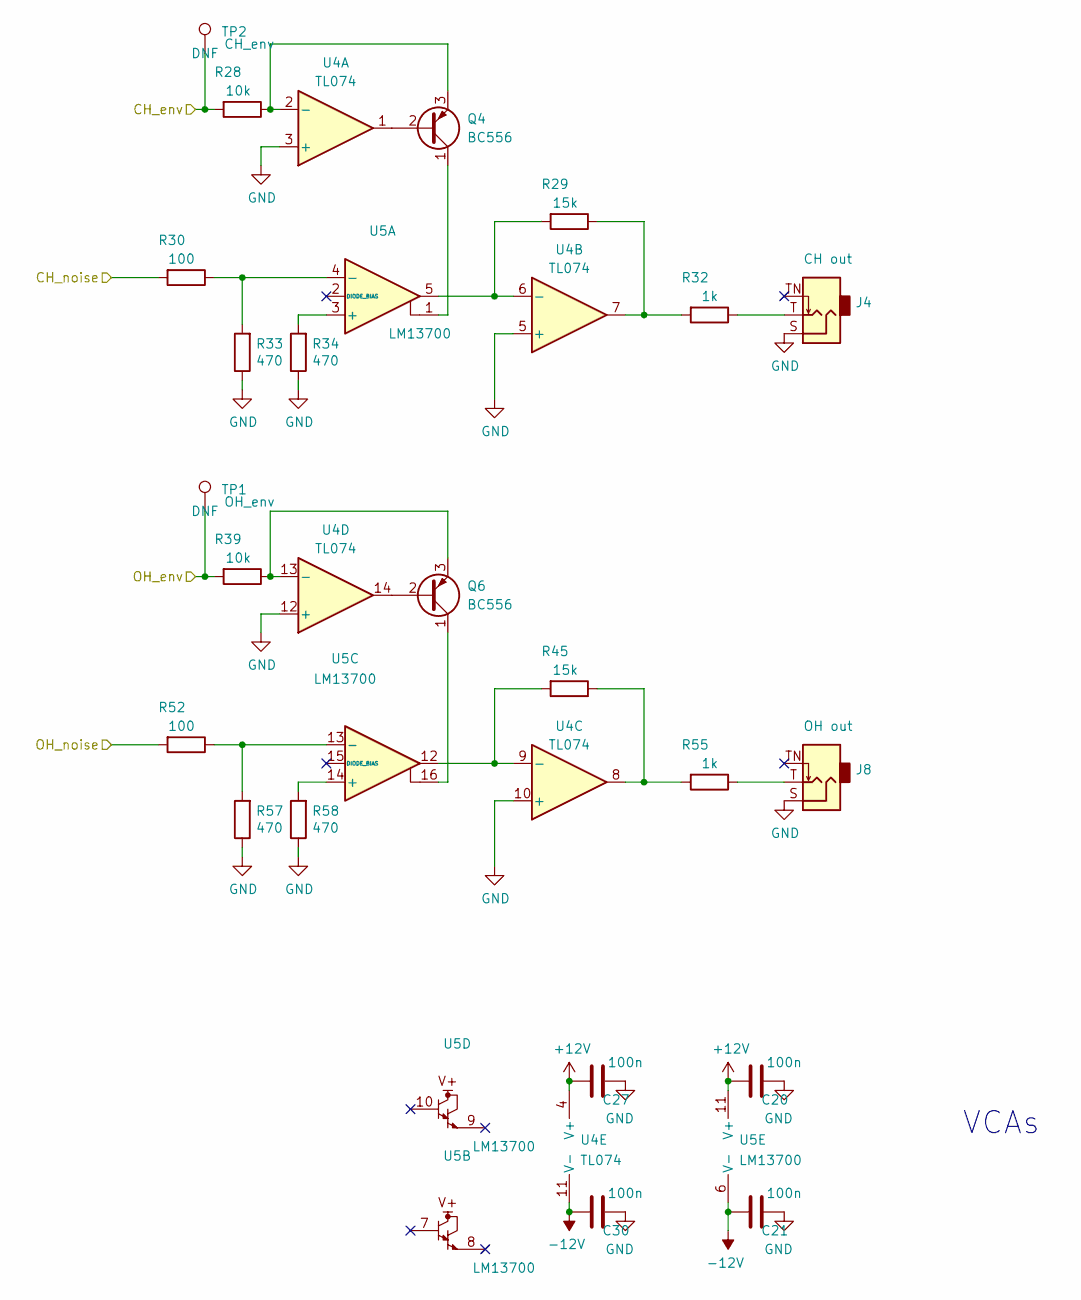
[picture p4: schematic VCAs.kicad_sch, hihat]

Parts:
C20, C21, C27, C30: 100n; C_Disc_D3.0mm_W1.6mm_P2.50mm
J4: CH out; Jack_6.35mm_PJ_629HAN
J8: OH out; Jack_6.35mm_PJ_629HAN
Q4, Q6: BC556; TO-92_Inline_Wide
R28, R39: 10k; R_Axial_DIN0207_L6.3mm_D2.5mm_P10.16mm_Horizontal
R29, R45: 15k; R_Axial_DIN0207_L6.3mm_D2.5mm_P10.16mm_Horizontal
R30, R52: 100; R_Axial_DIN0207_L6.3mm_D2.5mm_P10.16mm_Horizontal
R32, R55: 1k; R_Axial_DIN0207_L6.3mm_D2.5mm_P10.16mm_Horizontal
R33, R34, R57, R58: 470; R_Axial_DIN0207_L6.3mm_D2.5mm_P10.16mm_Horizontal
TP1: OH_env; TestPoint_THTPad_D1.5mm_Drill0.7mm
TP2: CH_env; TestPoint_THTPad_D1.5mm_Drill0.7mm
U4: TL074; DIP-14_W7.62mm_Socket_LongPads
U5: LM13700; DIP-16_W7.62mm_Socket_LongPads

Connections:
+12V: C20.2, C27.2, U4.4 (V+), U5.11 (V+); also elsewhere on the board
-12V: C21.2, C30.2, U4.11 (V-), U5.6 (V-); also elsewhere on the board
CH_env_brain: R28.2, TP2.1; also elsewhere on the board
CH_noise_att_brain: R30.2; also elsewhere on the board
GND: C20.1, C21.1, C27.1, C30.1, J4.S, J8.S, R33.1, R34.1, R57.1, R58.1, U4.3 (+), U4.5 (+), U4.10 (+), U4.12 (+); also elsewhere on the board
unnamed: J4.T, R32.1
unnamed: J8.T, R55.1
unnamed: Q4.1 (C), U5.1
unnamed: Q4.2 (B), U4.1
unnamed: Q4.3 (E), R28.1, U4.2 (-)
unnamed: Q6.1 (C), U5.16
unnamed: Q6.2 (B), U4.14
unnamed: Q6.3 (E), R39.1, U4.13 (-)
unnamed: R29.1, R32.2, U4.7
unnamed: R29.2, U4.6 (-), U5.5
unnamed: R30.1, R33.2, U5.4 (-)
unnamed: R34.2, U5.3 (+)
unnamed: R45.1, R55.2, U4.8
unnamed: R45.2, U4.9 (-), U5.12
unnamed: R52.1, R57.2, U5.13 (-)
unnamed: R58.2, U5.14 (+)
OH_env_brain: R39.2, TP1.1; also elsewhere on the board
OH_noise_att_brain: R52.2; also elsewhere on the board

Notes on the sheet:
VCAs

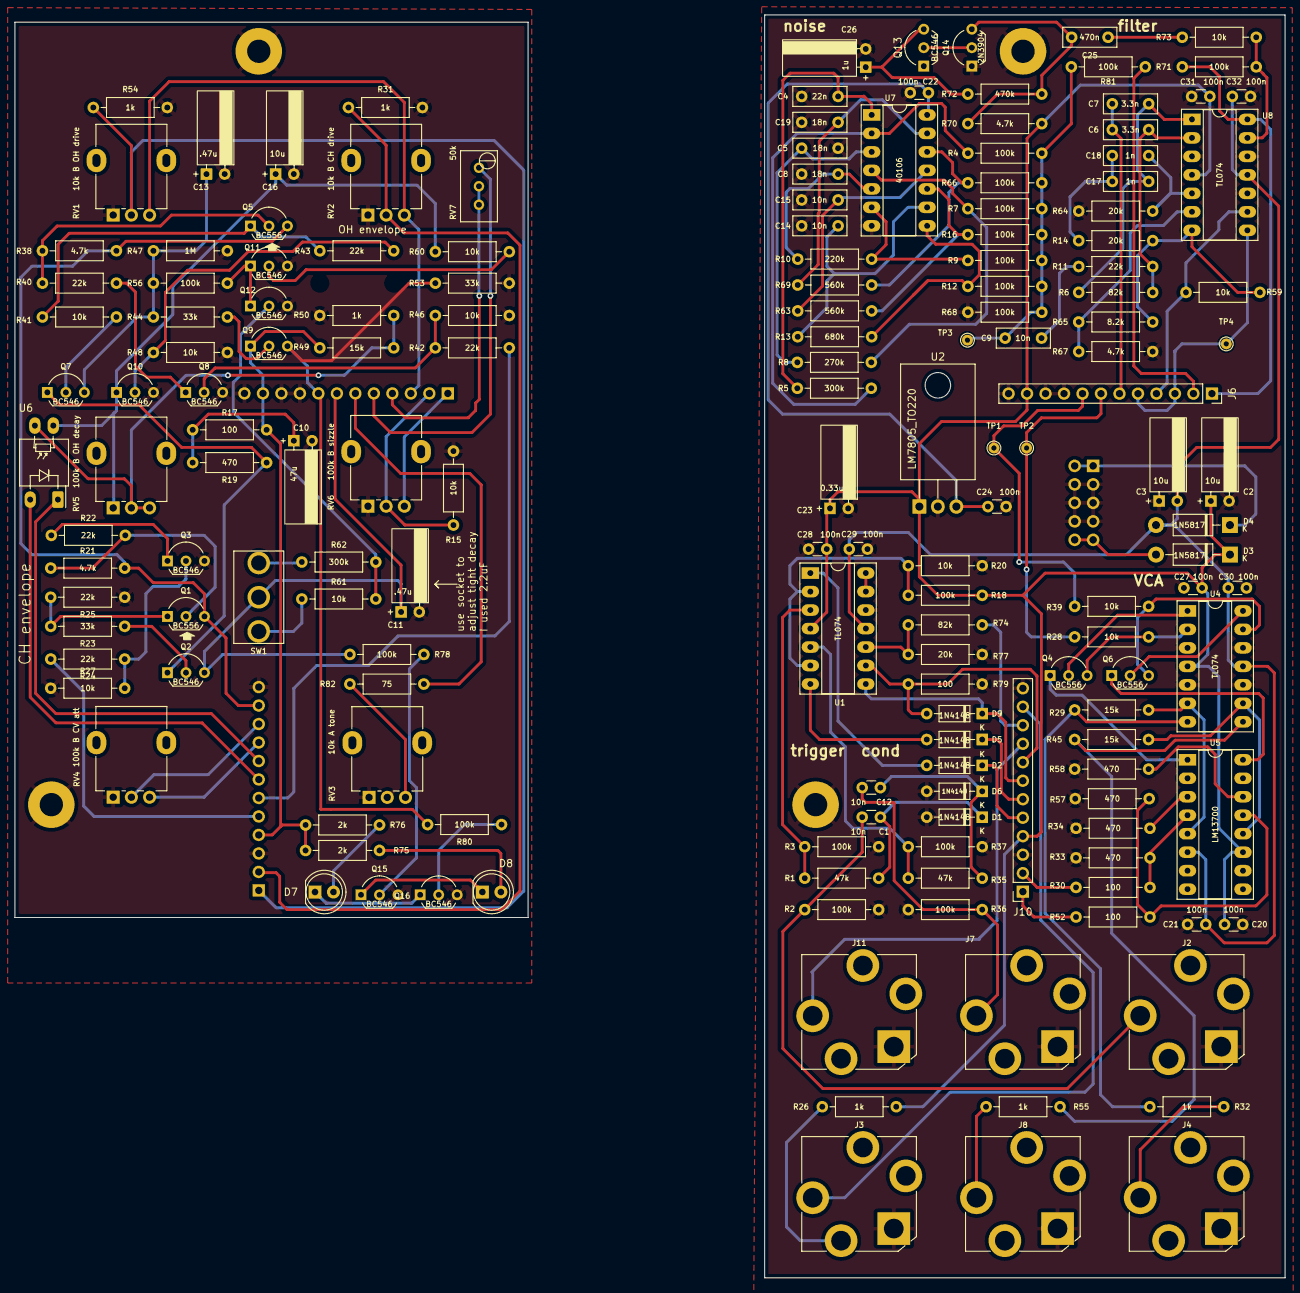
[picture p5: board hihat.kicad_pcb from above]

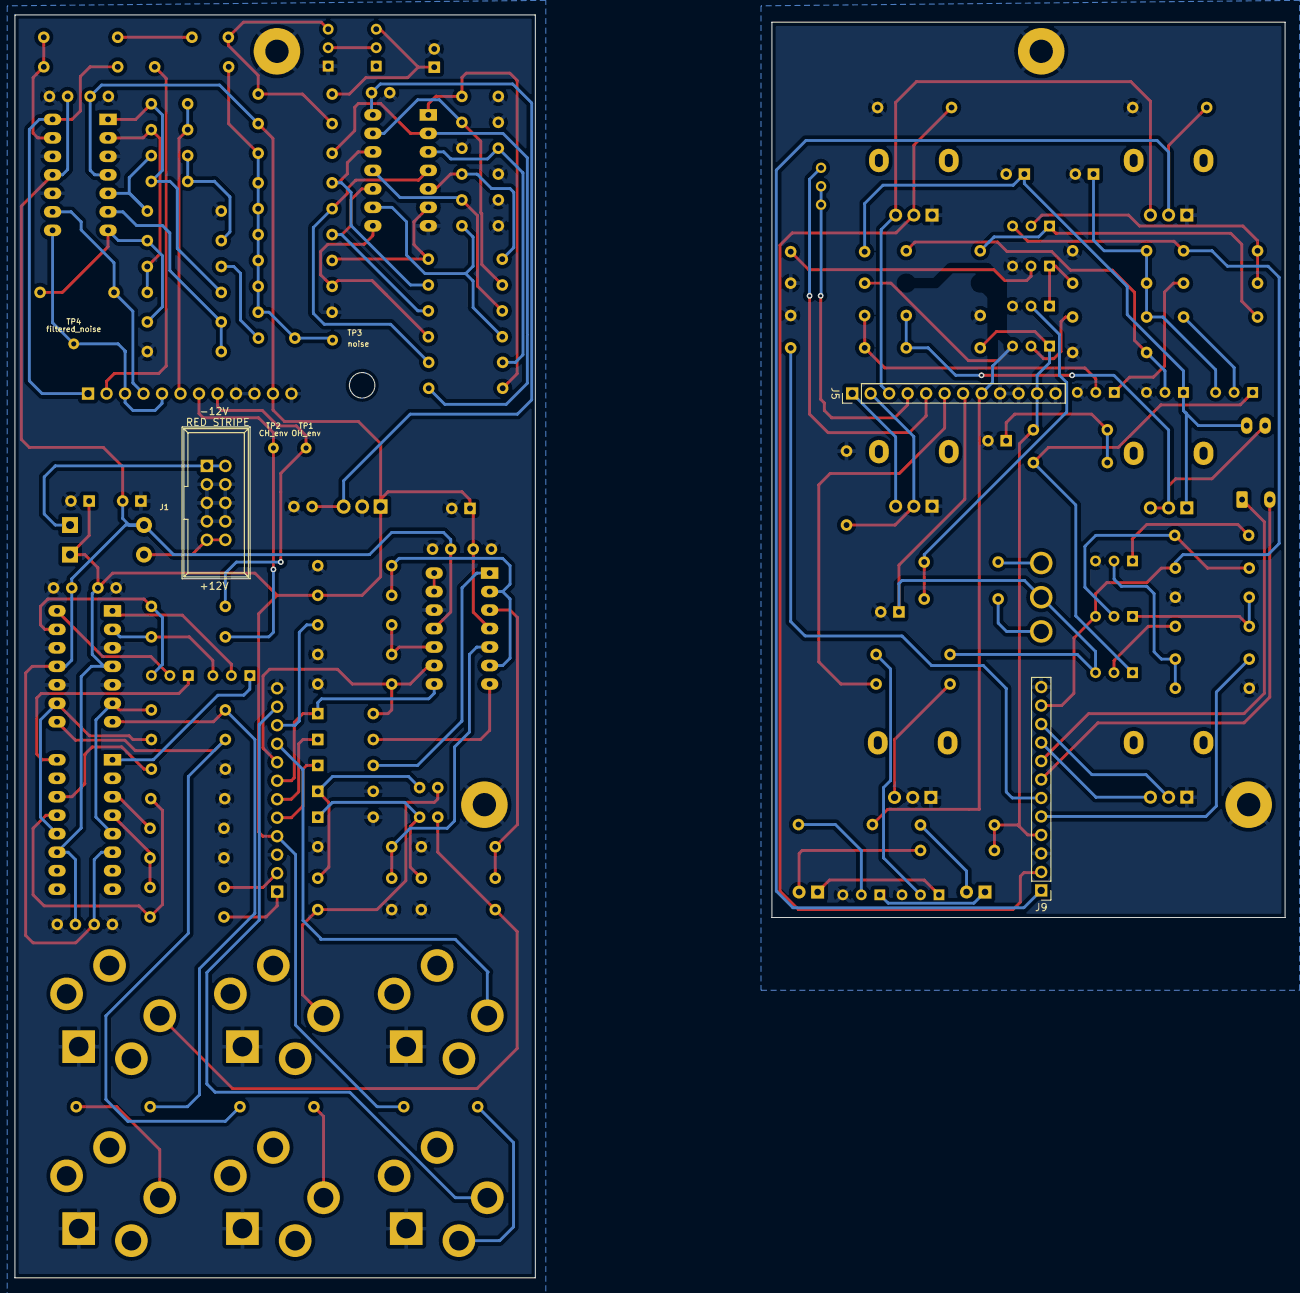
[picture p6: board hihat.kicad_pcb from below]

Board: 2 copper layers, 174.5 x 173.5 mm, 172 parts (3 on the bottom side), 121 nets.
