sebastianbeyer/SO_hihat/(commit log)

2022-01-16 gerber settings maybe?
    [hihat.kicad_pcb]
2022-02-01 fix noise section (1uF instead of 10uF), location of switch jacks!!, add resistor to make sizzle pot log-like and add note to use socket for cap to adjust tight decay
    [hihat.kicad_pcb, hihat.kicad_sch, noise_section.kicad_sch]
2022-02-01 probably only timestamp
    [hat.kicad_pcb]
2022-02-01 add resistor reference
    [hihat.kicad_sch]
2022-02-02 remove R51, now the open hat is much louder!
    [envelopes.kicad_sch, hihat.kicad_pcb, hihat.kicad_sch]
2022-02-02 change resistors in filter 18k to 20k
    [hihat.kicad_pcb, hihat.kicad_sch, noise_section.kicad_sch]
2022-11-22 add BOM
